brnna05/senior-design-strength-training/README.md

# senior-design-strength-training
Senior Design project for ECE 364D - Fitness wearable for strength training
