brnna05/senior-design-strength-training/machine-learning/plots/figure_20260218_140859.png

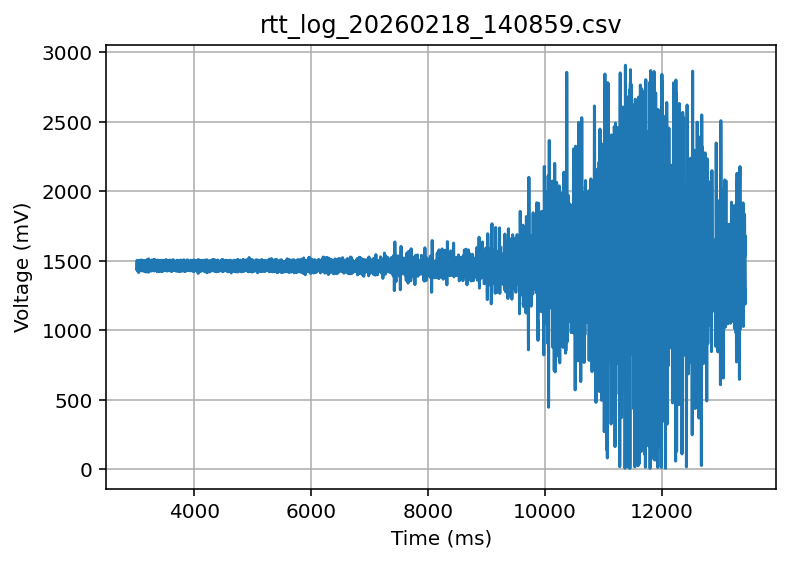
machine-learning/plots/figure_20260218_140859.png
