brnna05/senior-design-strength-training/machine-learning/plots/figure_20260218_141500.png

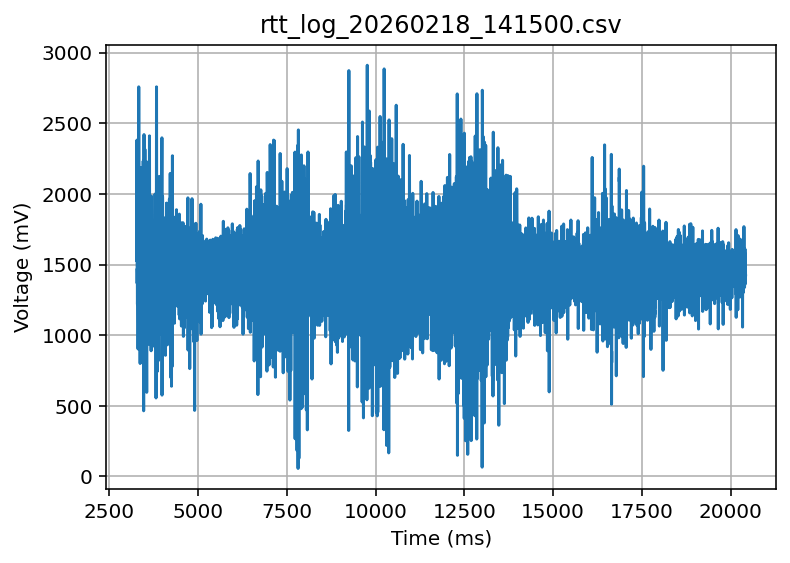
machine-learning/plots/figure_20260218_141500.png
