brnna05/senior-design-strength-training/machine-learning/plots/figure_20260218_141545.png

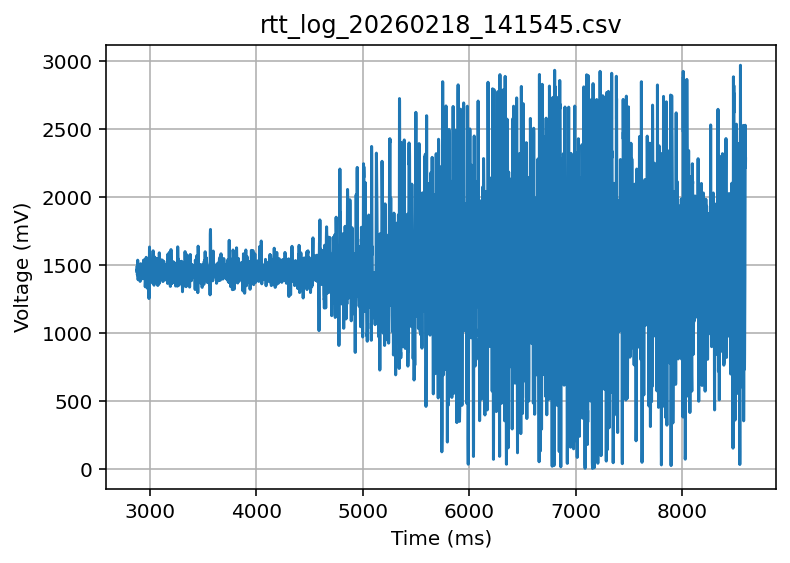
machine-learning/plots/figure_20260218_141545.png
