brnna05/senior-design-strength-training/machine-learning/plots/figure_20260218_142350.png

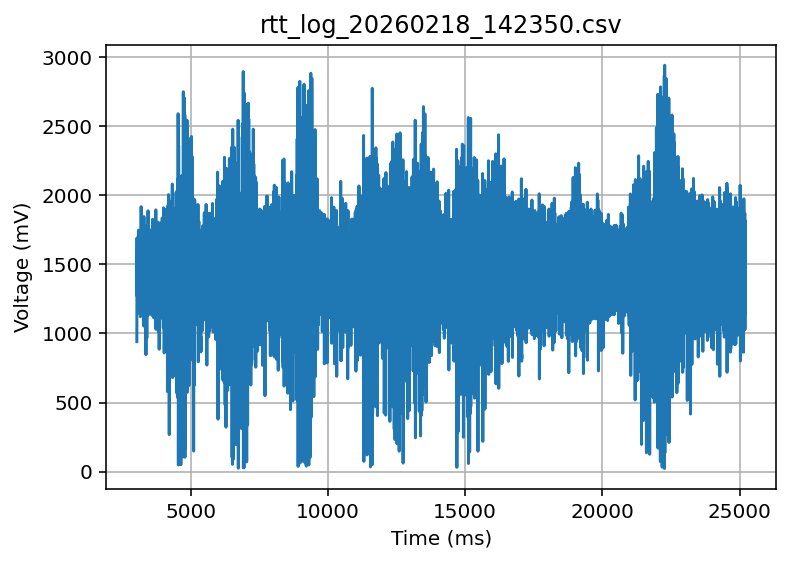
machine-learning/plots/figure_20260218_142350.png
