brnna05/senior-design-strength-training/machine-learning/plots/figure_20260218_142451.png

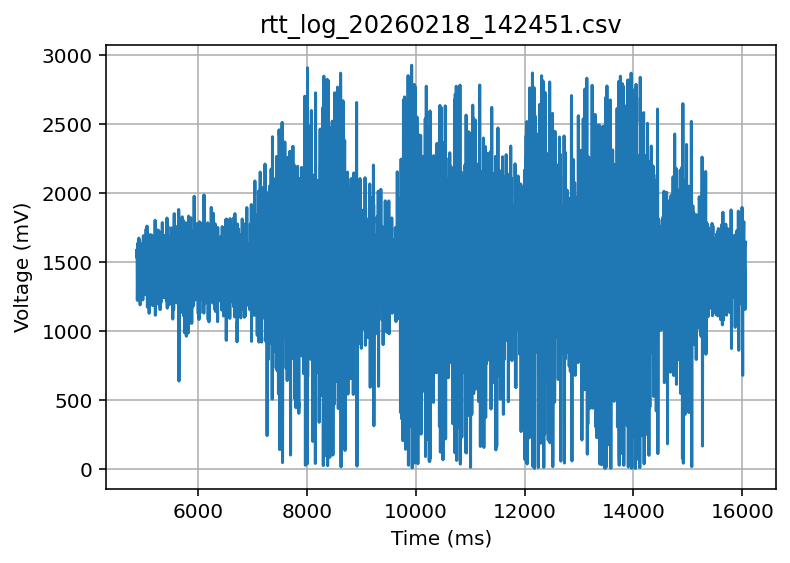
machine-learning/plots/figure_20260218_142451.png
