brnna05/senior-design-strength-training/machine-learning/plots/figure_20260304_135931.png

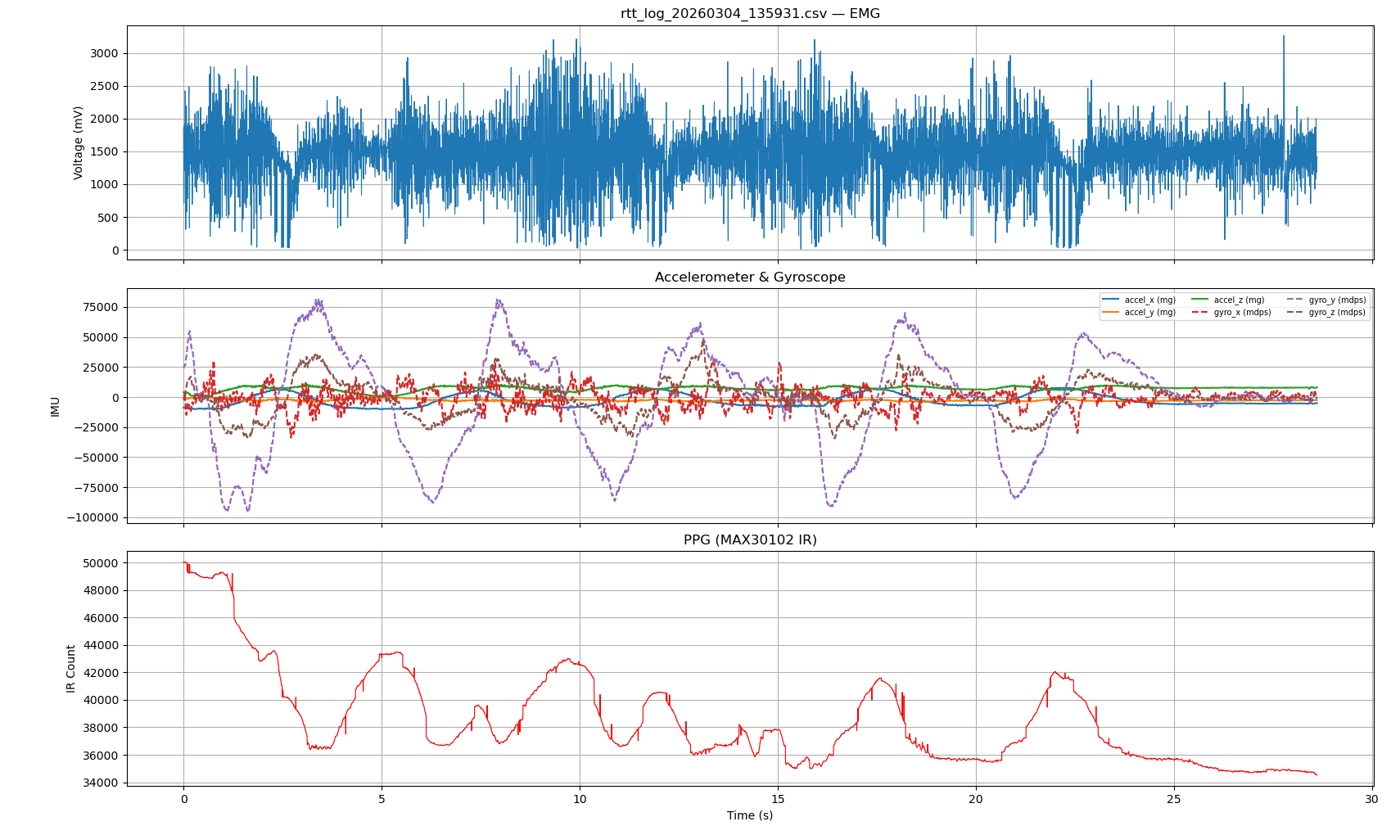
machine-learning/plots/figure_20260304_135931.png
