brnna05/senior-design-strength-training/machine-learning/plots/figure_20260311_135713.png

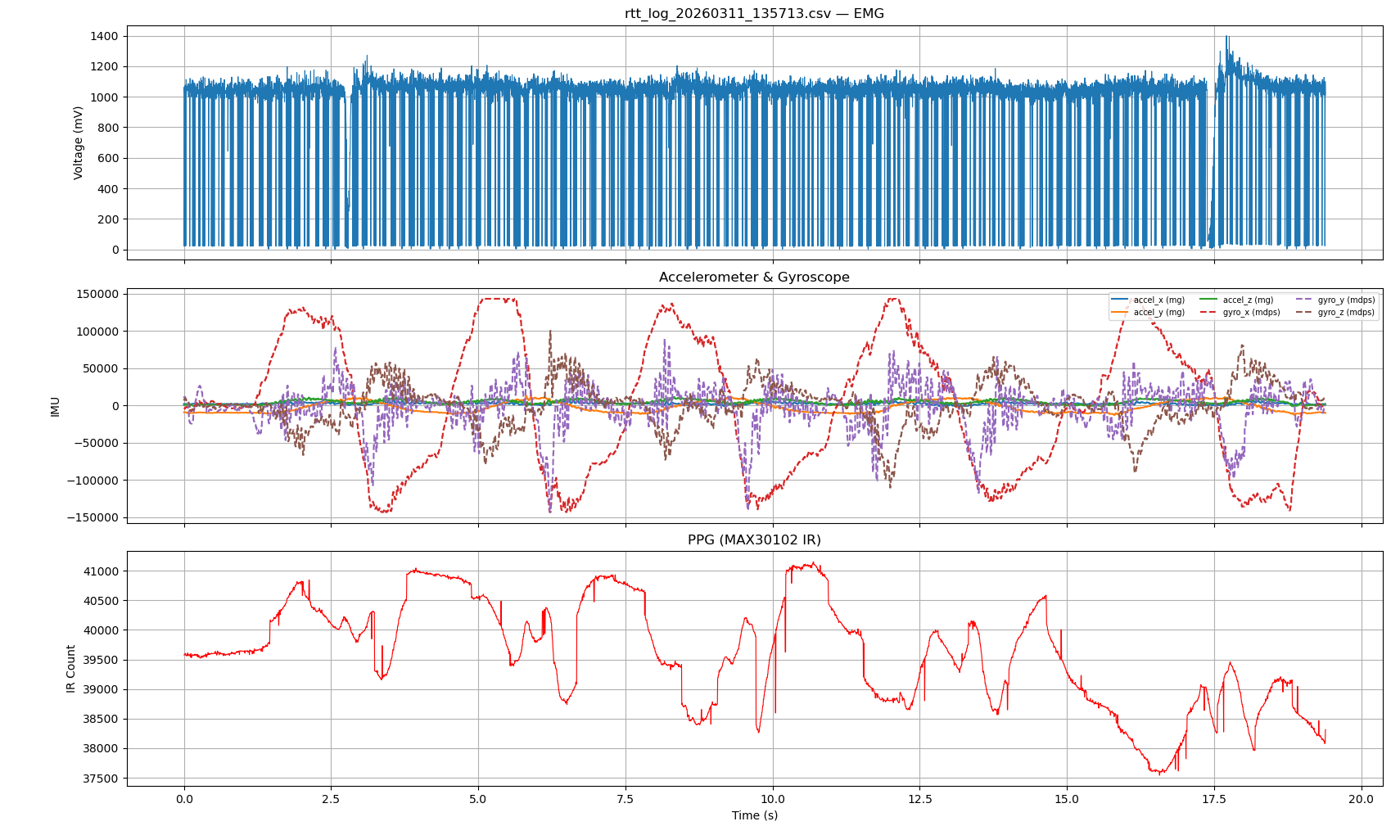
machine-learning/plots/figure_20260311_135713.png
