brnna05/senior-design-strength-training/machine-learning/plots/figure_20260311_140114.png

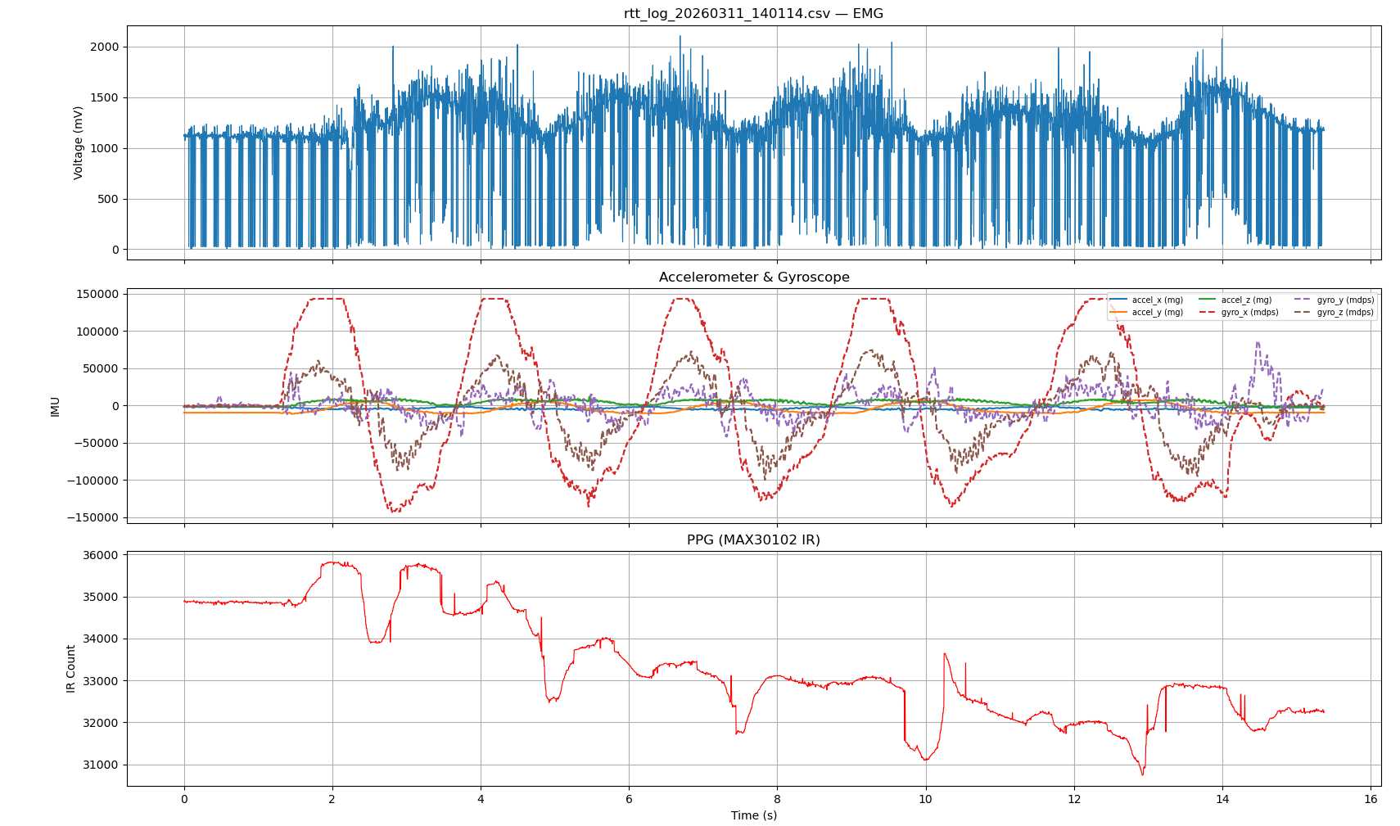
machine-learning/plots/figure_20260311_140114.png
