brnna05/senior-design-strength-training/machine-learning/plots/figure_20260311_145541.png

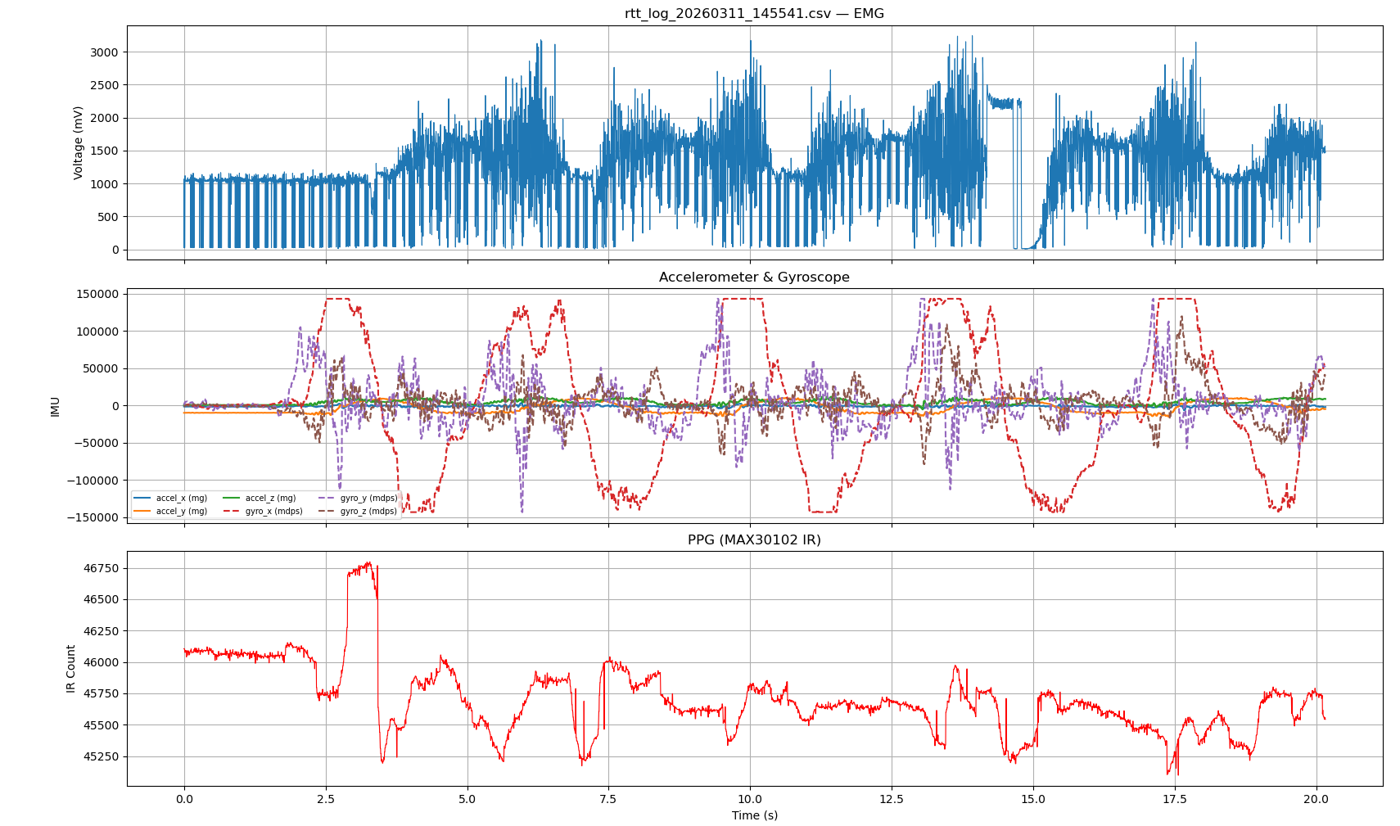
machine-learning/plots/figure_20260311_145541.png
