brnna05/senior-design-strength-training/machine-learning/plots/figure_20260311_151058.png

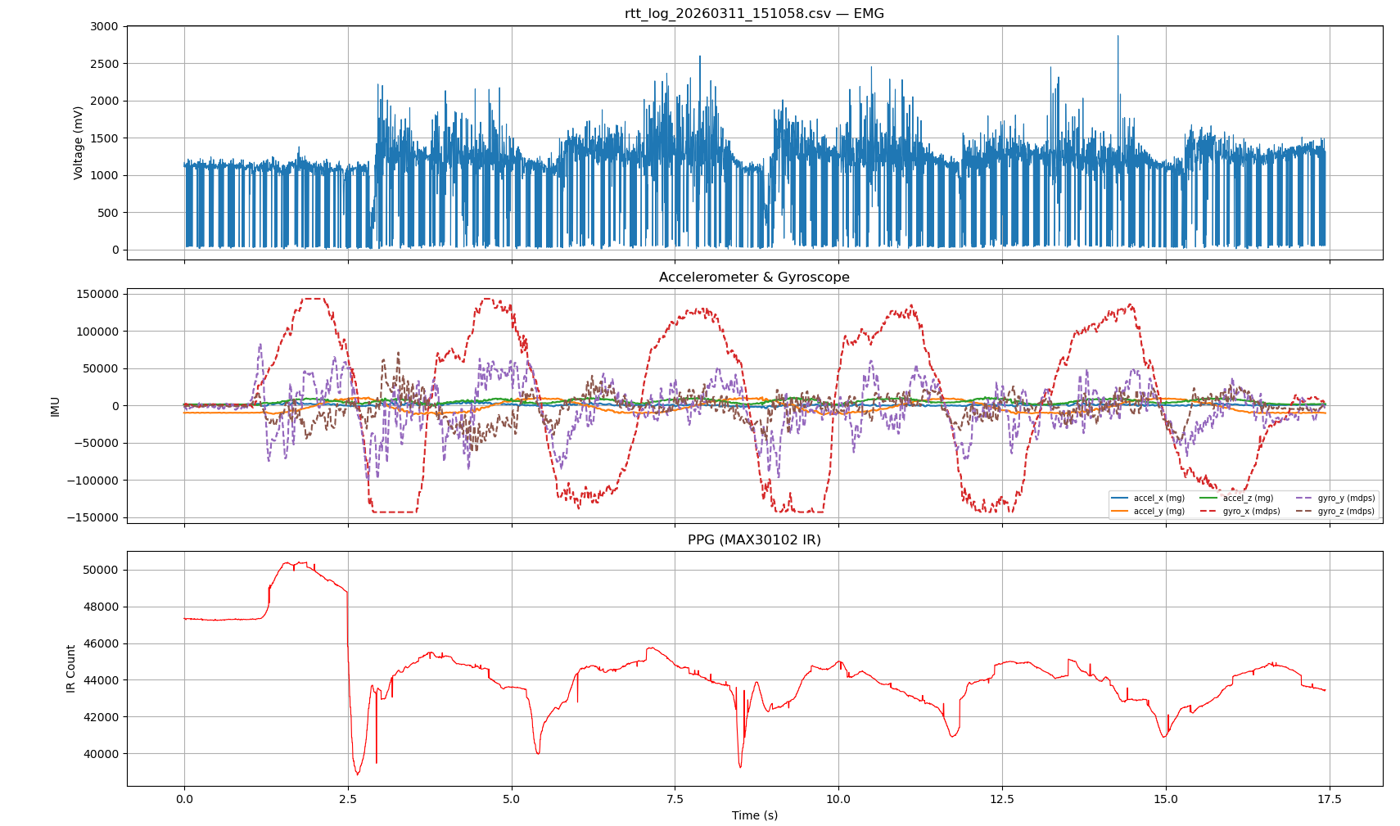
machine-learning/plots/figure_20260311_151058.png
