brnna05/senior-design-strength-training/app-software/wireframes/HistoryPage.pdf

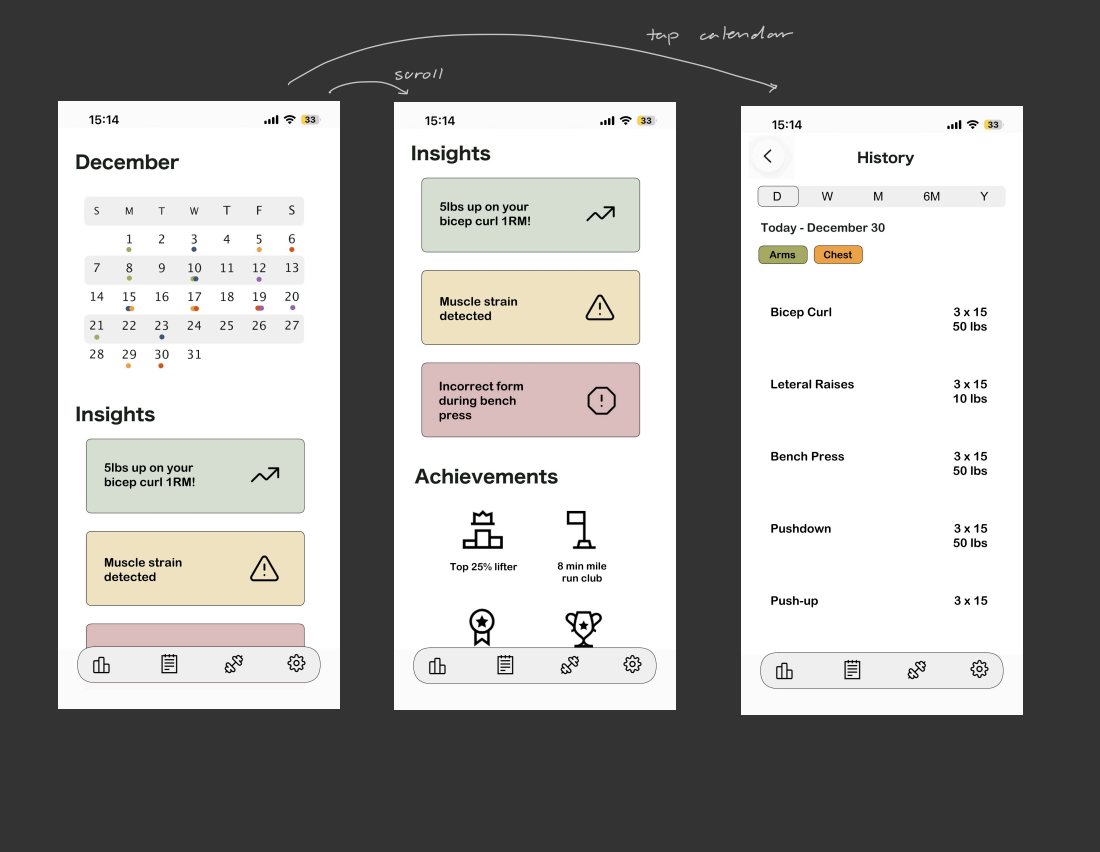
[picture p49: page 1]
