brnna05/senior-design-strength-training/app-software/wireframes/app-wireframes.pdf

# full-body

< | history

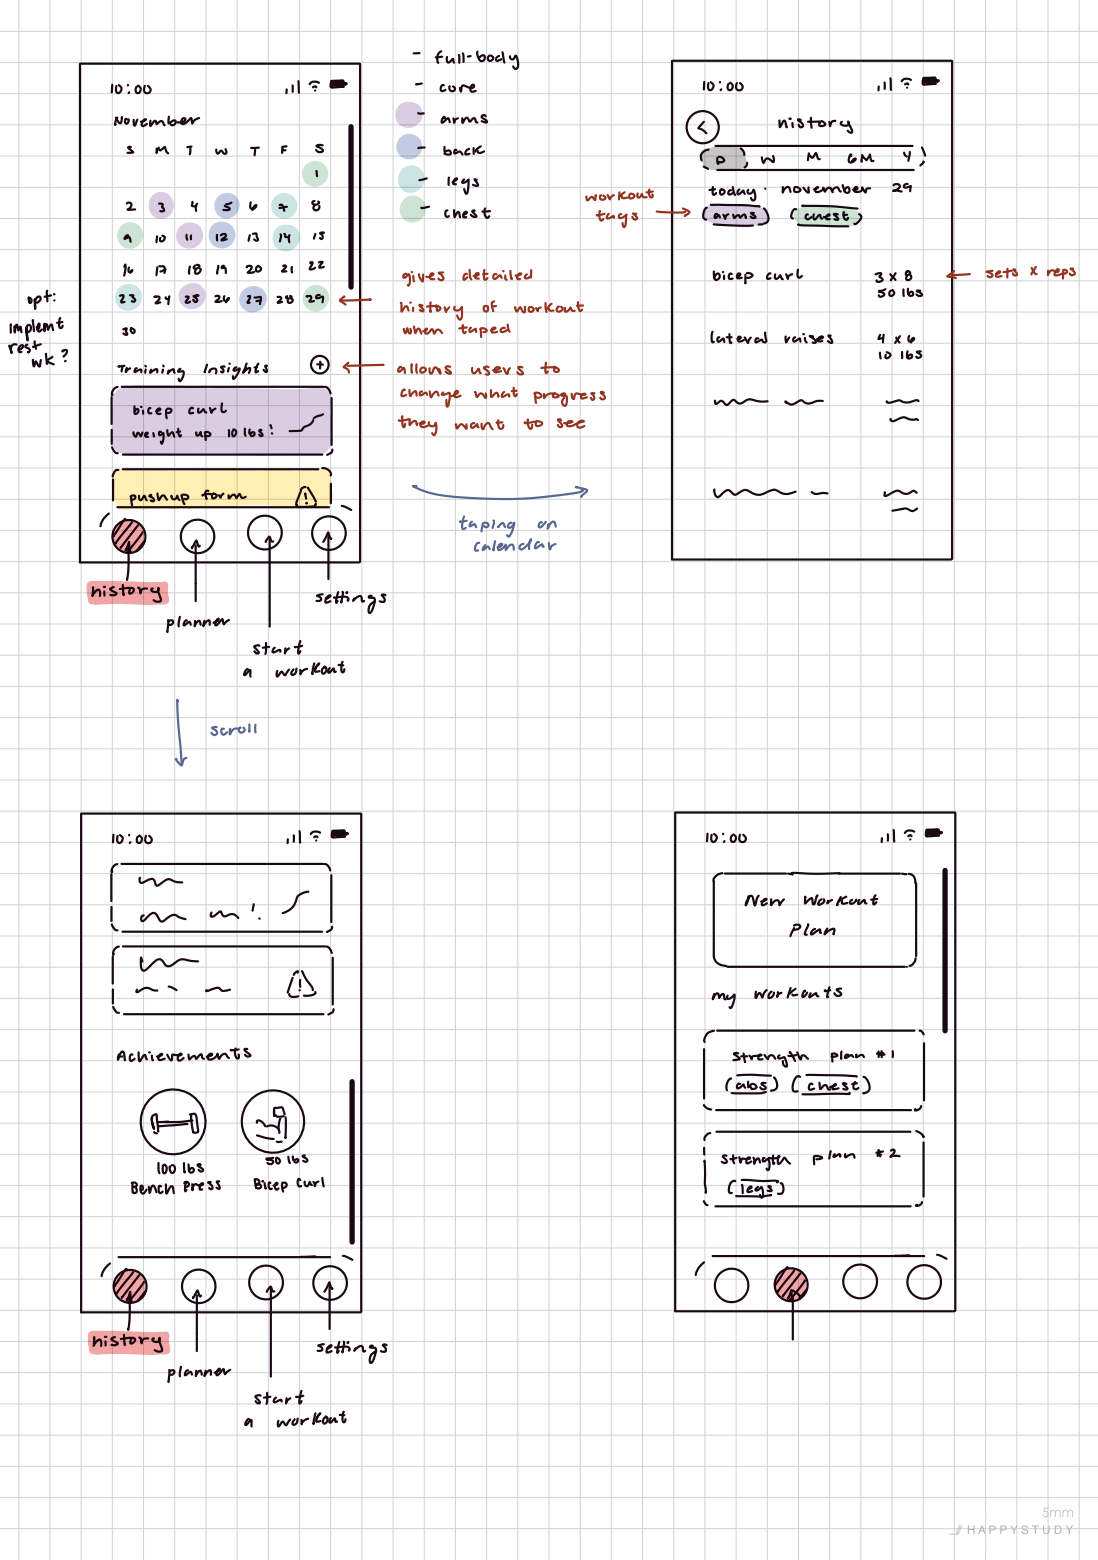
[picture p50: page 1]
cure; November; arms; Sin; back; legs; workout; today november; Chest; tuys; karms); Quest; gives; detailed; bicep; curl; Sets; reps; opt:; history of; implemt; when; taped; lateral; raises; restk ?; Training Insights; allows; users; change what; progress; weight up; they; want; see; pushup form; taping; calendar; New; Workout; Plan; work outS my L; Achievements; strength; plan #1; Es) (chest); plan; Bench; Press; Bicep curl; ↓ cen; history; settings; planner; Start

history | | planner | ↓ | Scroll | Start a | workout | settings

Q Strength | plan | #1
bicep curl | E.

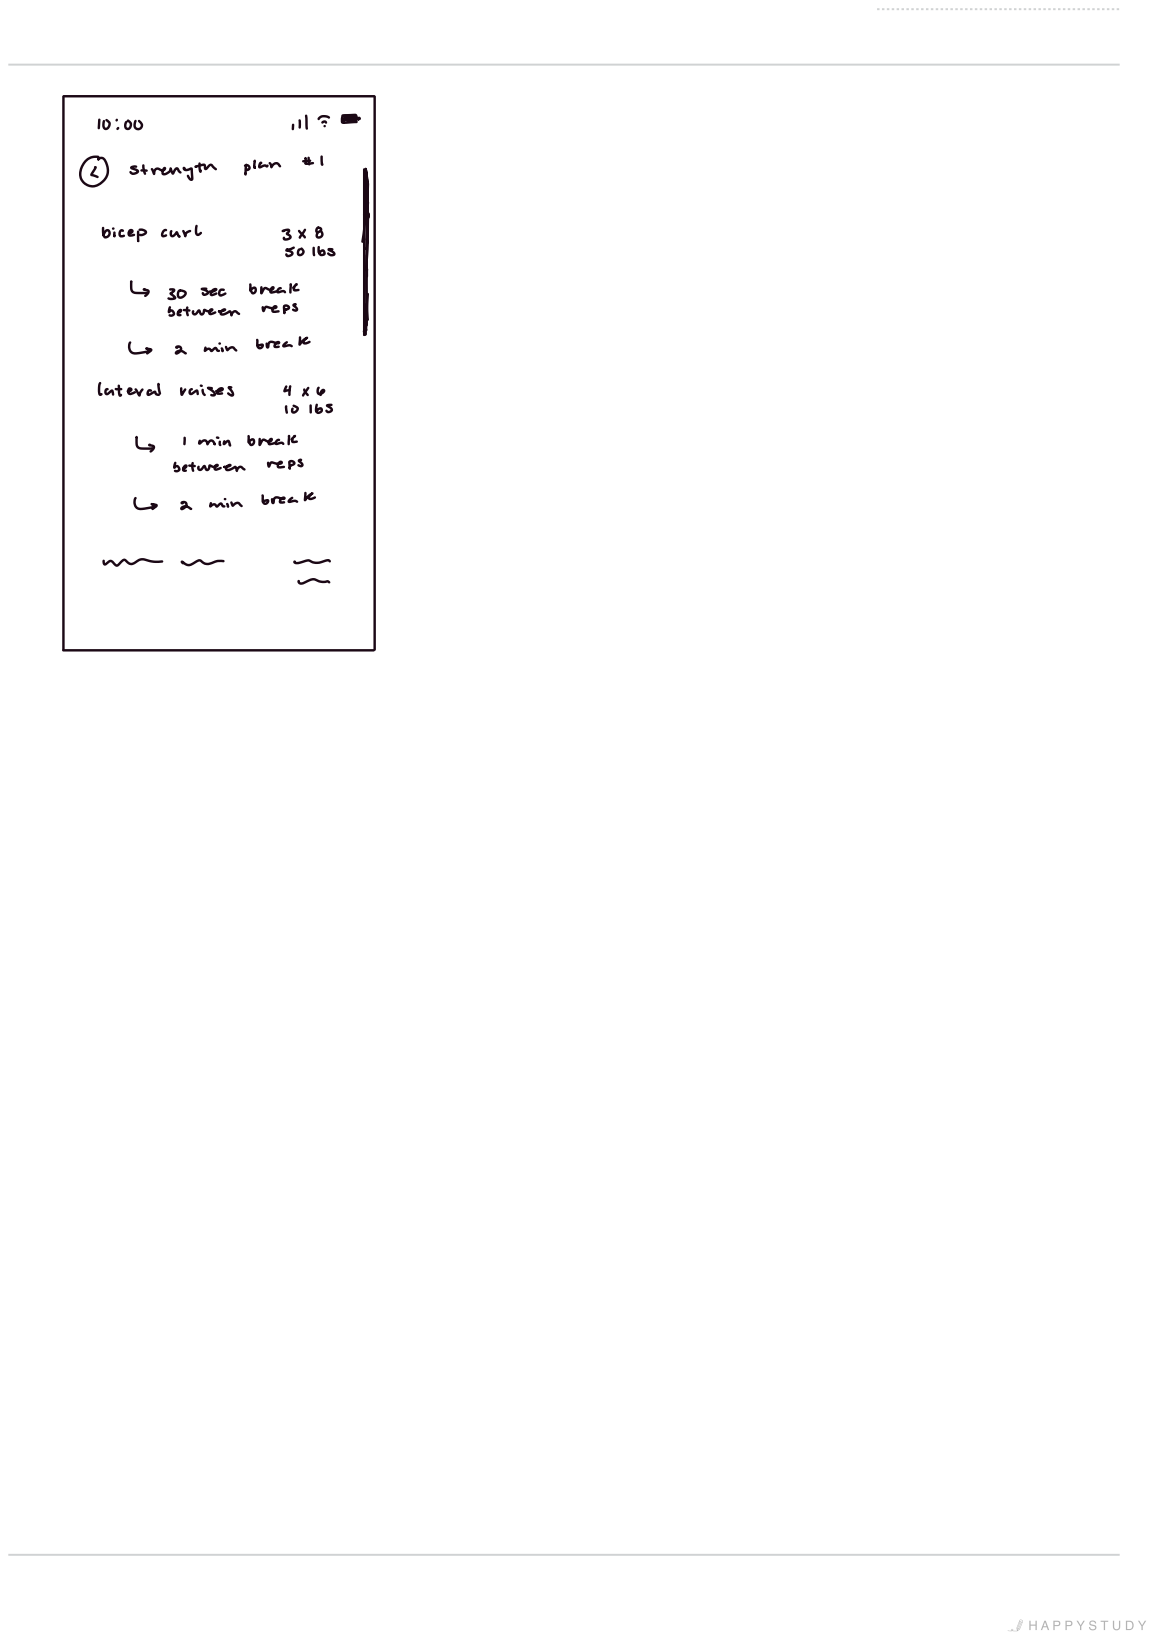
[picture p51: page 2]
between; see; break; reps; min; lateral; raises

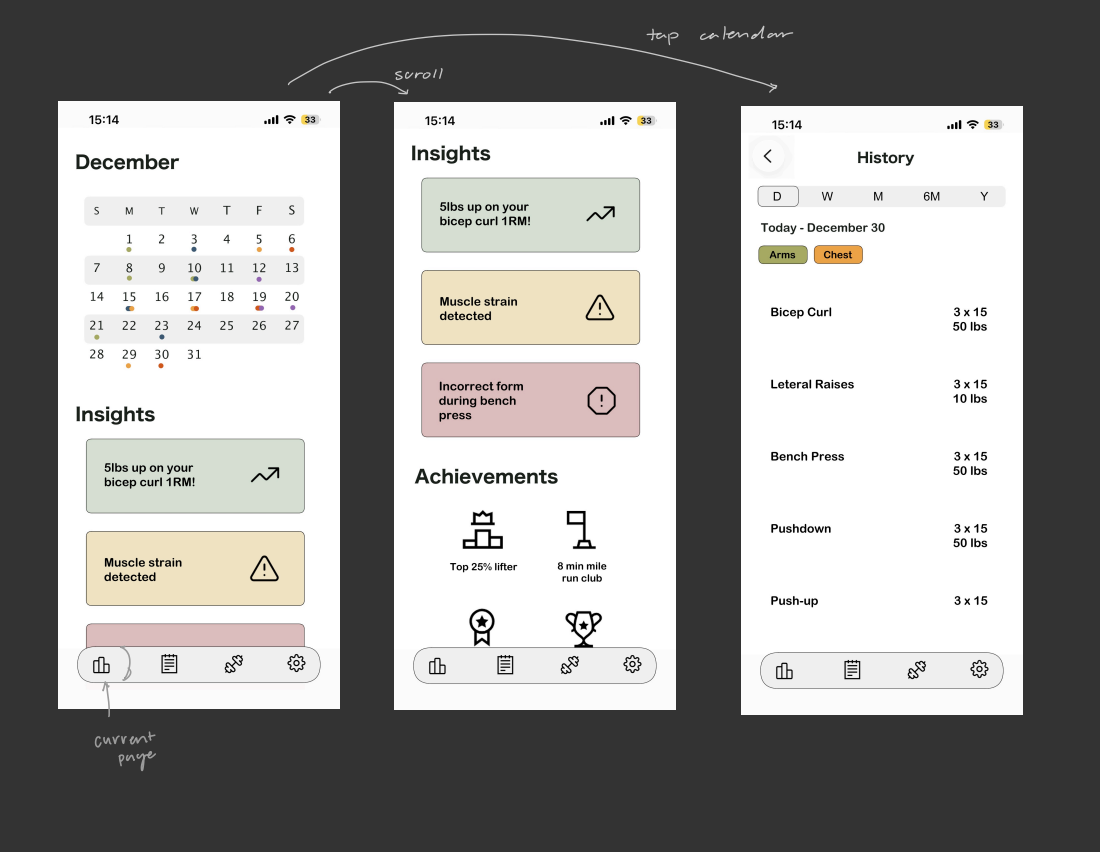
[picture p52: page 3]

Workout | Planner
#hada | new | runo | -

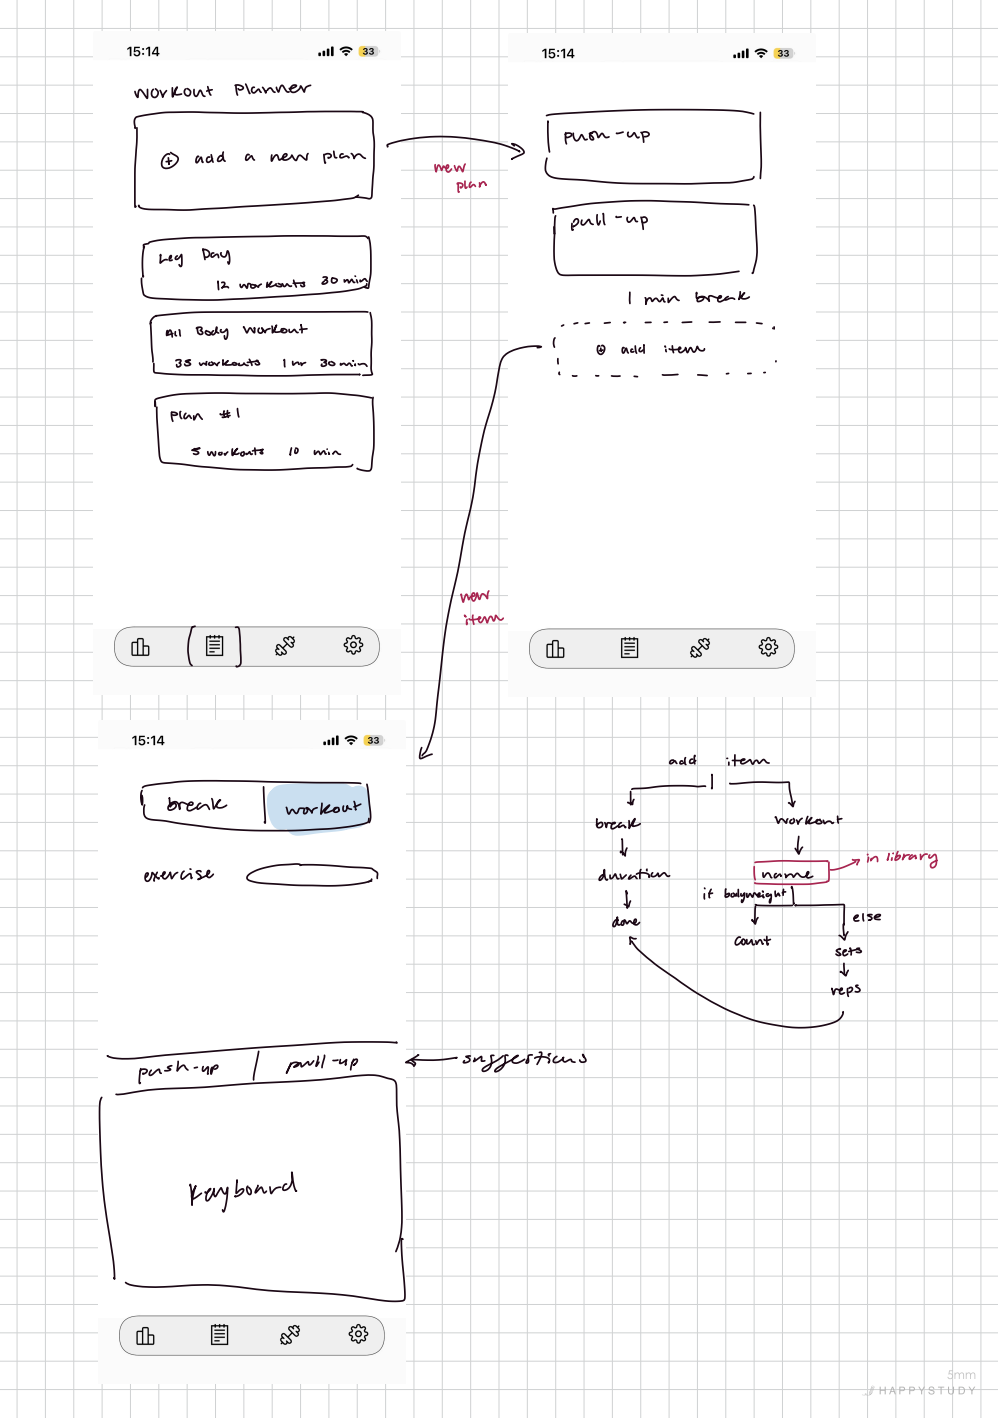
[picture p53: page 4]
Truan-up; plan; iteyeay; Trun-up workouts; 30 min; min; break; All; Body; Workout; aitem; add; item; ear/; workout; i11 break; Time-; in library; evercise; duration; bodyweight/; done; Telse; ↓ count; sets; -reps; -trush-no /; pull-upsuggestions; licting

select | a | workout

# plan

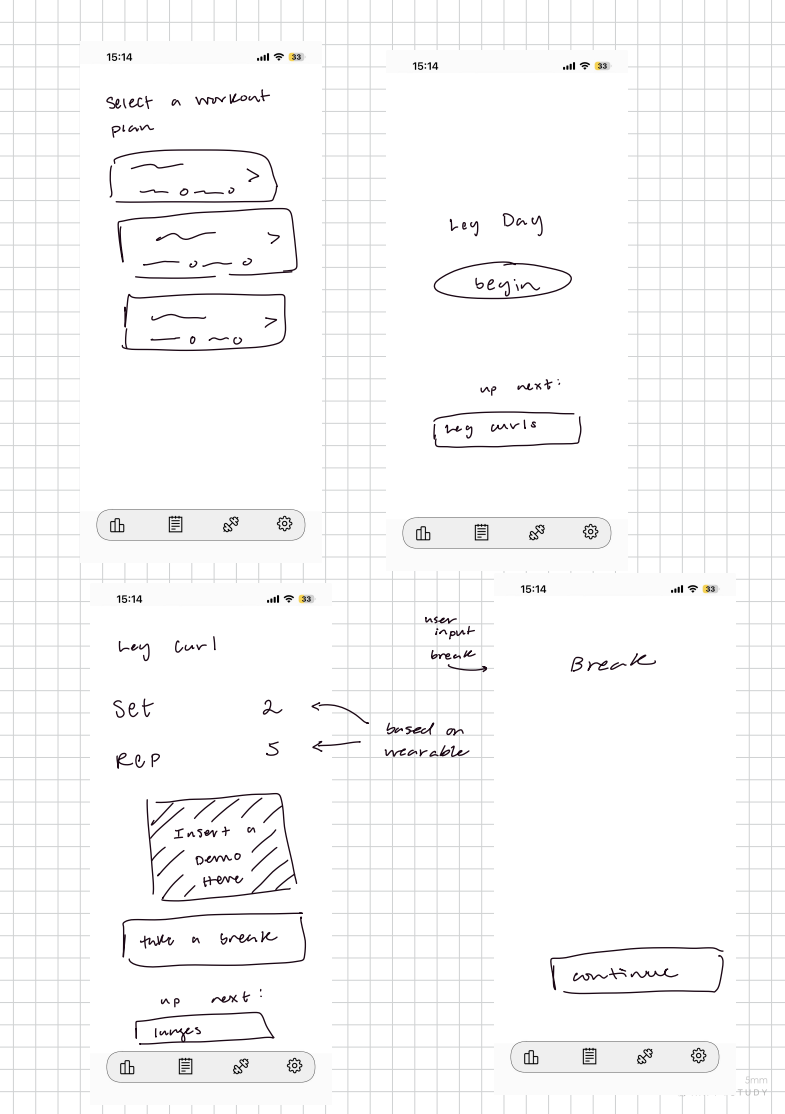
[picture p54: page 5]
For>; Ley; Day 7; Seyin; next :; Eycris; user input; hey; curl; break; - Break; set; based; wearable; RCP #; next; Fina; larges

# settings

# #count1

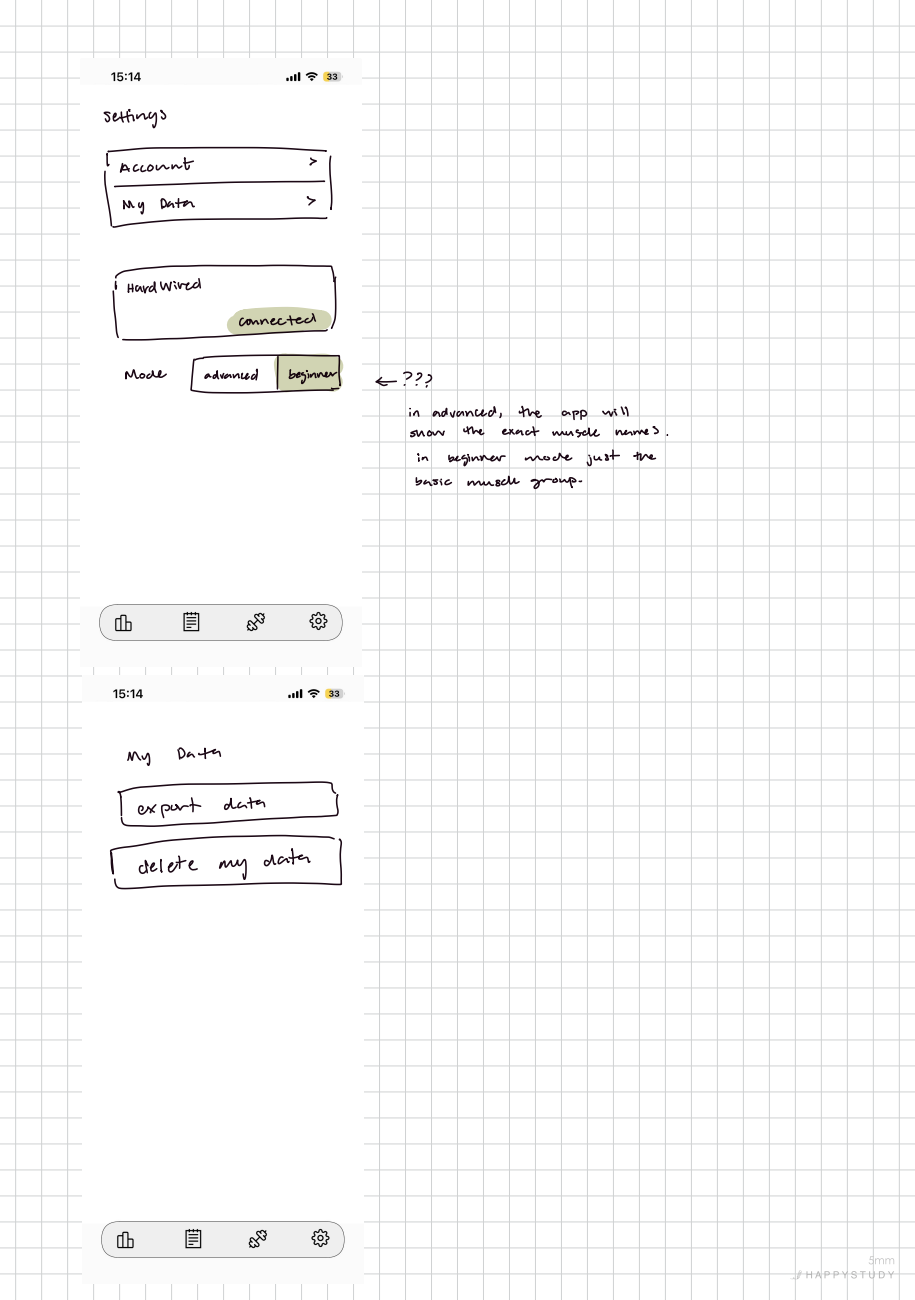
[picture p55: page 6]
Data; Hardwired; necical; moderanced/beginner; advanced ,; the; app; will; snow; exact; muscle; names .; beginner; mode; just the; basic; musch group-; Data t date etemy data
