brnna05/senior-design-strength-training/hardware/wearable/wearable.kicad_pcb

## KiCad design hardware/wearable/wearable.kicad_pcb (2026-03-15)

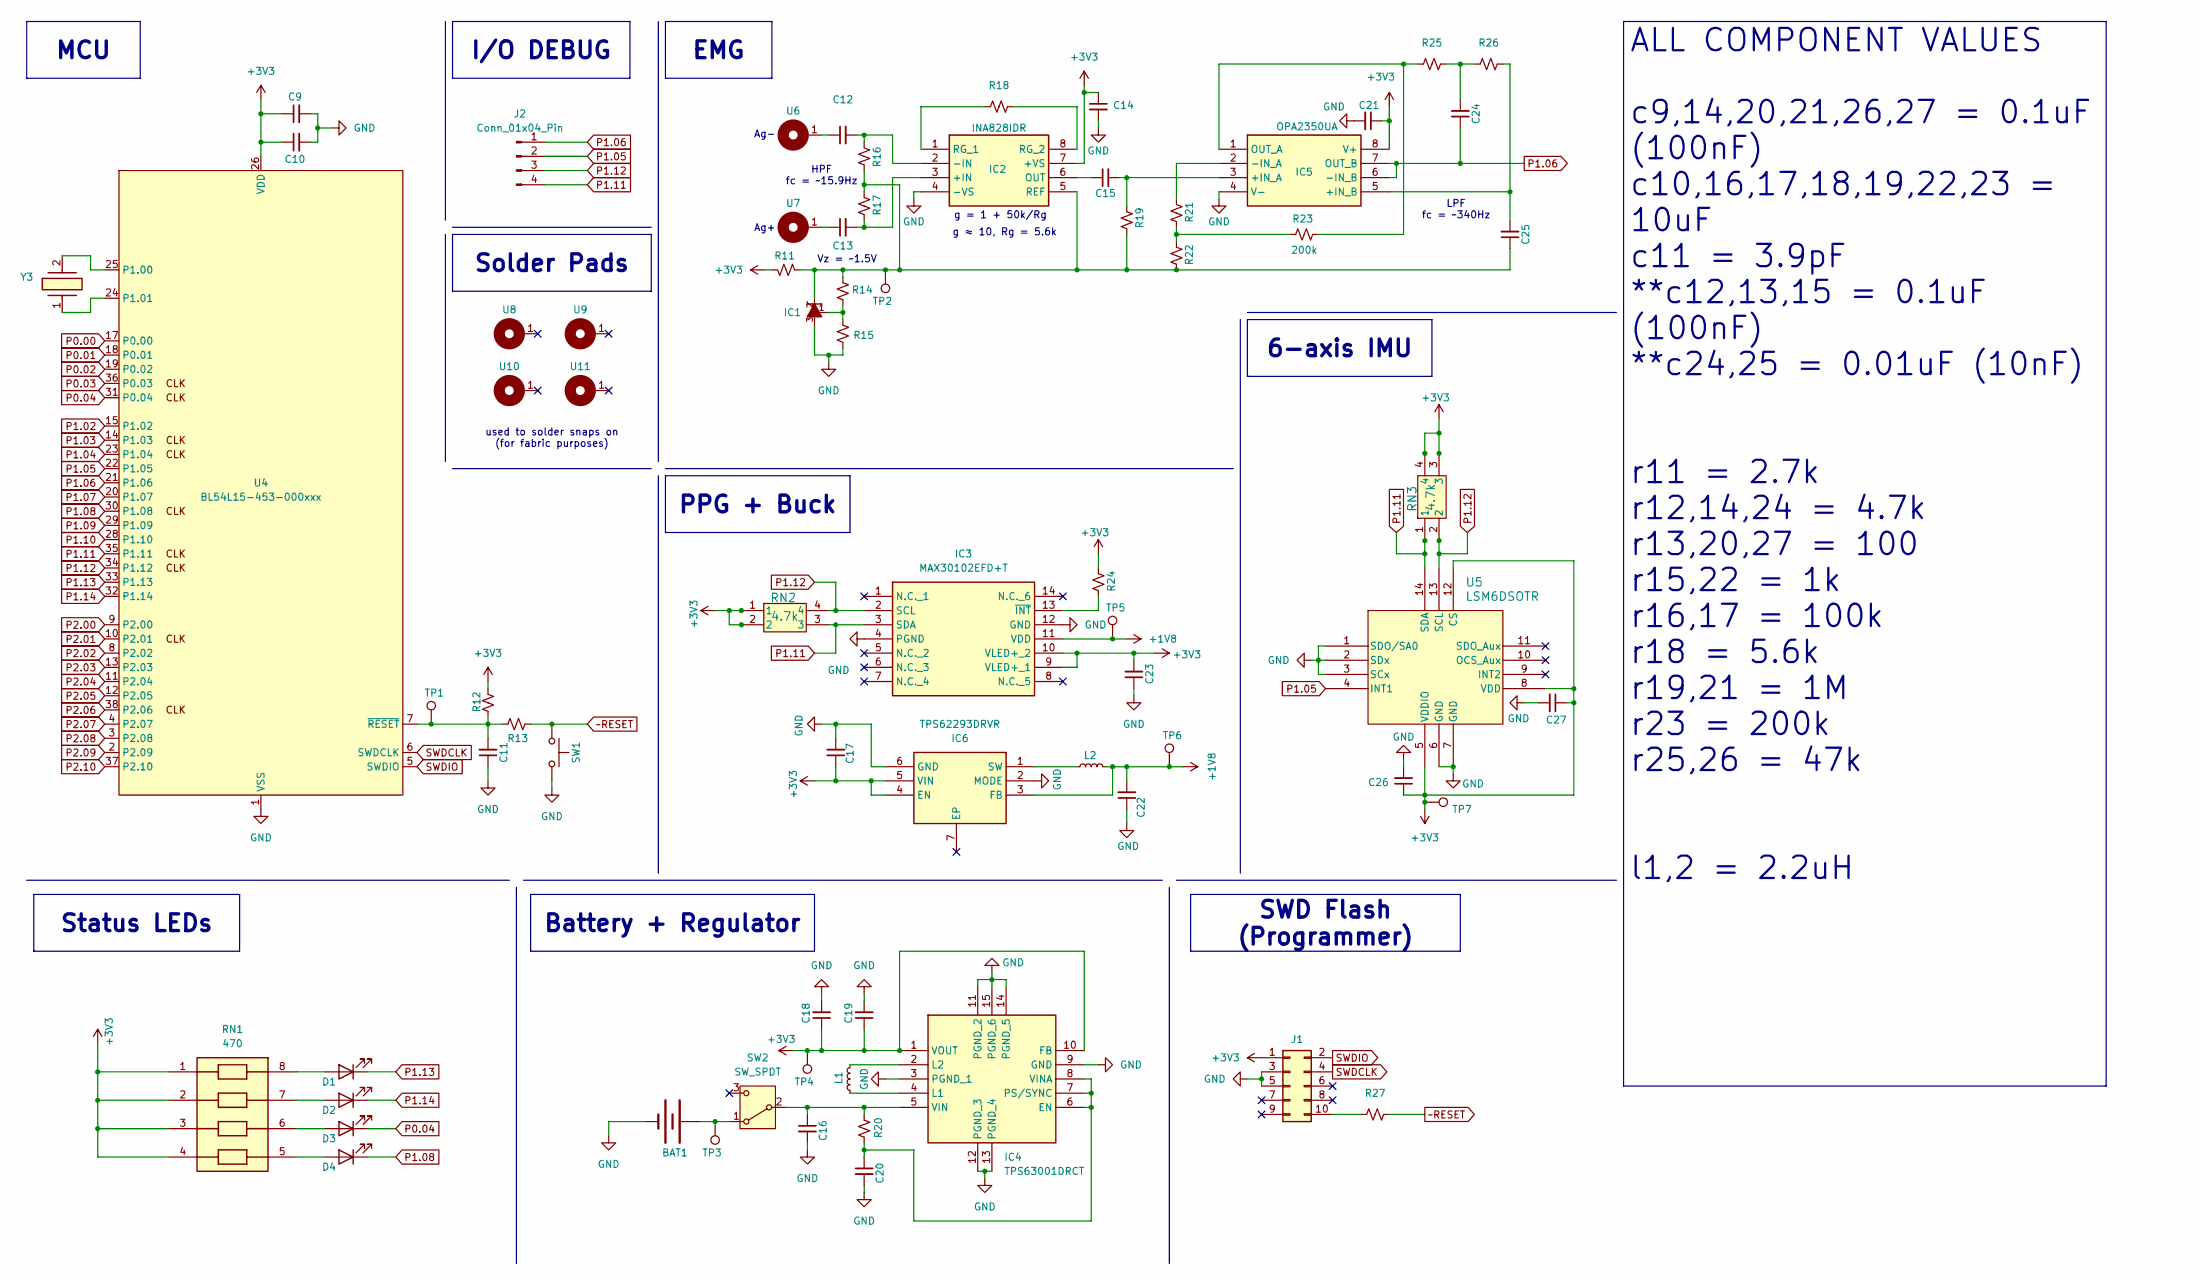
[picture p56: schematic pcb.kicad_sch]

Parts:
BAT1: 20mm coincell; batteryHolder
C9: 100nF; ceramicCap0_1uF
C10, C16, C17, C18, C19, C22, C23: 10uF; ceramicCap10uF
C11: 3.9pF; ceramicCap3_9pF
C12, C13, C15: 0.1uF; C0GCap0_1uF
C14, C20, C21, C26, C27: 0.1uF; ceramicCap0_1uF
C24, C25: 0.01uF; C0GCap0_01uF
D1, D2, D3, D4: LED; greenLed
IC1: LM4041CILPR; lm4041; Mouser Part Number 595-LM4041CILPR
IC2: INA828IDR; ina828; Mouser Part Number 595-INA828IDR
IC3: MAX30102EFD+T; ppg; Mouser Part Number 700-MAX30102EFD+T
IC4: TPS63001DRCT; boost3_3v; Mouser Part Number 595-TPS63001DRCT
IC5: OPA2350UA; opAmp; Mouser Part Number 595-OPA2350UA
IC6: TPS62293DRVR; buck1_8v; Mouser Part Number 595-TPS62293DRVR
J1: Conn_02x05_Odd_Even; swdConnector
J2: Conn_01x04_Pin; pinHeader1x4
L1, L2: 2.2uH; inductor
R11: 2.7k; res2K7
R12, R14, R24: 4.7k; res4K7
R13, R20, R27: 100; res100
R15, R22: 1k; res1K
R16, R17: 100k; res100K
R18: 5.6k; res5K6
R19, R21: 1M; res1M
R23: 200k; res200K
R25, R26: 47k; red47K
RN1: 470; resArray4; Mouser Part Number 603-YC164-JR-07470RL
RN2, RN3: 4.7k; resArray2
SW1: SW_Push; button
SW2: SW_SPDT; spdt
TP1, TP2, TP3, TP4, TP5, TP6, TP7: TestPoint; testPoint
U4: BL54L15-453-000xxx; BL54Lxx-LGA-39_14x10mm
U5: LSM6DSOTR; imu
U6, U7: silverContacts
U8, U9, U10, U11: solderPad
Y3: NX3215SA-32.768K-STD-MUA-8; crystal32768; Mouser Part Number 344-NX3215SA32768K8

Connections:
+1V8: C22.2, IC3.11 (VDD), IC6.3 (FB), L2.1, TP5.1, TP6.1
+3V3: C9.1, C10.1, C14.1, C17.1, C18.1, C19.1, C21.1, C23.2, C26.1, C27.1, IC2.7 (+VS), IC3.9 (VLED+_1), IC3.10 (VLED+_2), IC4.1 (VOUT), IC4.10 (FB), IC5.8 (V+), IC6.4 (EN), IC6.5 (VIN), J1.1, R11.1, R12.1, R24.1, RN1.1, RN1.2, RN1.3, RN1.4, RN2.1, RN2.2, RN3.3, RN3.4, TP4.1, TP7.1, U4.26 (VDD), U5.5 (VDDIO), U5.8 (VDD), U5.12 (CS)
GND: BAT1.NEGATIVE (-), C9.2, C10.2, C11.1, C14.2, C16.2, C17.2, C18.2, C19.2, C20.2, C21.2, C22.1, C23.1, C26.2, C27.2, IC1.3, IC2.4 (-VS), IC3.4 (PGND), IC3.12 (GND), IC4.3 (PGND_1), IC4.9 (GND), IC4.11 (PGND_2), IC4.12 (PGND_3), IC4.13 (PGND_4), IC4.14 (PGND_5), IC4.15 (PGND_6), IC5.4 (V-), IC6.2 (MODE), IC6.6 (GND), J1.3, J1.5, R15.2, SW1.2, U4.1 (VSS), U4.16 (VSS), U4.27 (VSS), U4.39 (VSS), U5.1 (SDO/SA0), U5.2 (SDx), U5.3 (SCx), U5.6 (GND), U5.7 (GND)
unnamed: C12.1, U6.1
unnamed: C13.1, U7.1
unnamed: C24.2, R25.2, R26.1
unnamed: D1.2 (A), RN1.8
unnamed: D2.2 (A), RN1.7
unnamed: D3.2 (A), RN1.6
unnamed: D4.2 (A), RN1.5
unnamed: IC1.1, R14.2, R15.1
unnamed: C13.2, IC2.3 (+IN), R17.2
unnamed: C12.2, IC2.2 (-IN), R16.1
unnamed: C15.1, IC2.6 (OUT)
unnamed: C25.1, IC1.2, IC2.5 (REF), R11.2, R14.1, R16.2, R17.1, R19.2, R22.2, TP2.1
unnamed: IC2.1 (RG_1), R18.1
unnamed: IC2.8 (RG_2), R18.2
unnamed: IC3.13 (~INT), R24.2
unnamed: C20.1, IC4.6 (EN), IC4.7 (PS/SYNC), IC4.8 (VINA), R20.2
unnamed: IC4.4 (L1), L1.1
unnamed: IC4.2 (L2), L1.2
unnamed: C16.1, IC4.5 (VIN), R20.1, SW2.2 (B)
unnamed: C15.2, IC5.3 (+IN_A), R19.1
unnamed: C25.2, IC5.5 (+IN_B), R26.2
unnamed: IC5.2 (-IN_A), R21.1
unnamed: IC5.1 (OUT_A), R23.2, R25.1
unnamed: IC6.1 (SW), L2.2
unnamed: J1.10, R27.1
unnamed: R21.2, R22.1, R23.1
unnamed: BAT1.POSITIVE@1 (+), BAT1.POSITIVE@2 (+), BAT1.POSITIVE@3 (+), BAT1.POSITIVE@4 (+), SW2.1 (A), TP3.1
unnamed: U4.25 (P1.00), Y3.2 (CRYSTAL_2)
unnamed: U4.24 (P1.01), Y3.1
unnamed: C11.2, R12.2, R13.1, TP1.1, U4.7 (~RESET)
P0.00: U4.17 (P0.00)
P0.01: U4.18 (P0.01)
P0.02: U4.19 (P0.02)
P0.03: U4.36 (P0.03)
P0.04: D3.1 (K), U4.31 (P0.04)
P1.02: U4.15 (P1.02)
P1.03: U4.14 (P1.03)
P1.04: U4.23 (P1.04)
P1.05: J2.2, U4.22 (P1.05), U5.4 (INT1)
P1.06: C24.1, IC5.6 (-IN_B), IC5.7 (OUT_B), J2.1, U4.21 (P1.06)
P1.07: U4.20 (P1.07)
P1.08: D4.1 (K), U4.30 (P1.08)
P1.09: U4.29 (P1.09)
P1.10: U4.28 (P1.10)
P1.11: IC3.3 (SDA), J2.4, RN2.3, RN3.1, U4.35 (P1.11), U5.14 (SDA)
P1.12: IC3.2 (SCL), J2.3, RN2.4, RN3.2, U4.34 (P1.12), U5.13 (SCL)
P1.13: D1.1 (K), U4.33 (P1.13)
P1.14: D2.1 (K), U4.32 (P1.14)
P2.00: U4.9 (P2.00)
P2.01: U4.10 (P2.01)
P2.02: U4.8 (P2.02)
P2.03: U4.13 (P2.03)
P2.04: U4.11 (P2.04)
P2.05: U4.12 (P2.05)
P2.06: U4.38 (P2.06)
P2.07: U4.4 (P2.07)
P2.08: U4.3 (P2.08)
P2.09: U4.2 (P2.09)
P2.10: U4.37 (P2.10)
SWDCLK: J1.4, U4.6 (SWDCLK)
SWDIO: J1.2, U4.5 (SWDIO)
~RESET: R13.2, R27.2, SW1.1

Notes on the sheet:
HPF fc = ~15.9Hz
g ≈ 10, Rg = 5.6k
Vz = ~1.5V
Ag+
Ag-
used to solder snaps on (for fabric purposes)
g = 1 + 50k/Rg
LPF fc = ~340Hz
I/O DEBUG
MCU
6-axis IMU
EMG
SWD Flash (Programmer)
ALL COMPONENT VALUES c9,14,20,21,26,27 = 0.1uF (100nF) c10,16,17,18,19,22,23 = 10uF c11 = 3.9pF **c12,13,15 = 0.1uF (100nF) **c24,25 = 0.01uF (10nF) r11 = 2.7k r12,14,24 = 4.7k r13,20,27 = 100 r15,22 = 1k r16,17 = 100k r18 = 5.6k r19,21 = 1M r23 = 200k r25,26 = 47k l1,2 = 2.2uH
Solder Pads
Battery + Regulator
Status LEDs
PPG + Buck

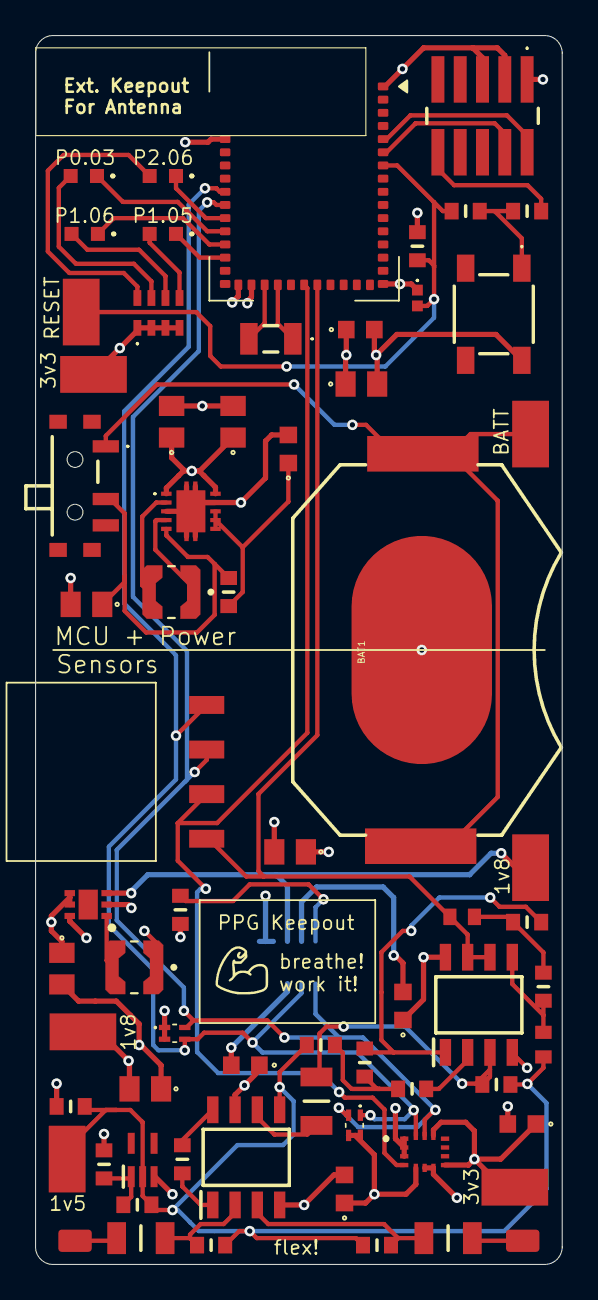
[picture p57: board wearable.kicad_pcb from above]

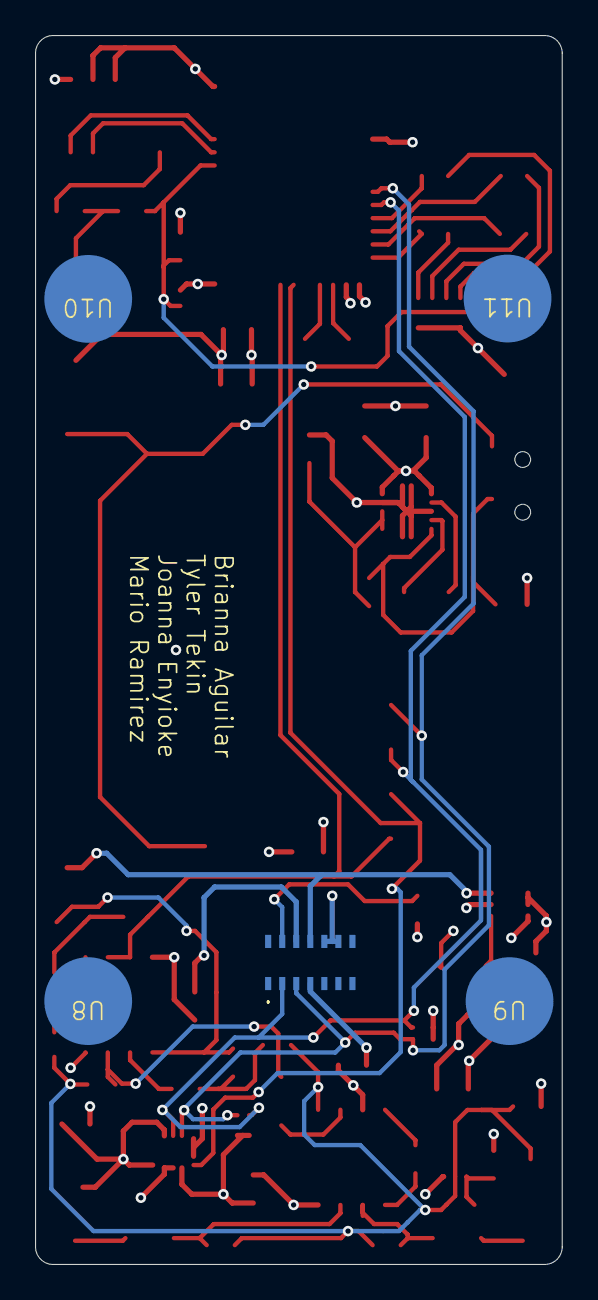
[picture p58: board wearable.kicad_pcb from below]

Board: 4 copper layers, 30.0 x 70.0 mm, 72 parts (5 on the bottom side), 44 nets.
