brnna05/senior-design-strength-training/firmware/src/main.cpp

#include <zephyr/kernel.h>
#include <zephyr/bluetooth/bluetooth.h>
#include <zephyr/bluetooth/hci.h>
#include <zephyr/bluetooth/conn.h>
#include <zephyr/bluetooth/gatt.h>
#include <zephyr/drivers/gpio.h>
#include "PPG.hpp"
#include "IMU.h"
#include "ADC.h"
#include "classifier.h"

/* ── Message types — keep in sync with RN app ── */
#define MSG_REP     0x01   /* [0x01, rep_count_uint8]   — new rep detected  */
#define MSG_BPM     0x02   /* [0x02, bpm_uint8]         — heart rate update  */
#define MSG_FATIGUE 0x03   /* [0x03, fatigue_level 0-3] — fatigue update     */

/*
 * Classifier tick rate (ms).
 * 100 ms gives 10 Hz resolution for rep detection.
 * Matches CLASSIFIER_PERIOD_MS defined in classifier.c.
 */
#define CLASSIFIER_PERIOD_MS  100

/*
 * How often to push a BPM + fatigue notification over BLE (ms).
 * 1 s is the finest useful resolution given the PPG algorithm.
 */
#define BPM_NOTIFY_PERIOD_MS 5000

static const struct bt_le_adv_param *adv_param = BT_LE_ADV_PARAM(
    BT_LE_ADV_OPT_CONNECTABLE,
    BT_GAP_ADV_FAST_INT_MIN_2,
    BT_GAP_ADV_FAST_INT_MAX_2,
    NULL);

static const struct bt_data ad[] = {
    BT_DATA_BYTES(BT_DATA_FLAGS, (BT_LE_AD_GENERAL | BT_LE_AD_NO_BREDR)),
    BT_DATA(BT_DATA_NAME_COMPLETE,
            CONFIG_BT_DEVICE_NAME,
            sizeof(CONFIG_BT_DEVICE_NAME) - 1),
};

static const struct bt_data sd[] = {
    BT_DATA_BYTES(BT_DATA_UUID128_ALL,
        BT_UUID_128_ENCODE(0x12340001, 0x0000, 0x0000, 0x0000, 0x000000000001)),
};

/* ── UUIDs — keep in sync with RN app ── */
static const struct bt_uuid_128 rep_svc_uuid = BT_UUID_INIT_128(
    BT_UUID_128_ENCODE(0x12340001, 0x0000, 0x0000, 0x0000, 0x000000000001));

static const struct bt_uuid_128 rep_char_uuid = BT_UUID_INIT_128(
    BT_UUID_128_ENCODE(0x12340001, 0x0000, 0x0000, 0x0000, 0x000000000002));

/* ── GATT service ── */
BT_GATT_SERVICE_DEFINE(rep_svc,
    BT_GATT_PRIMARY_SERVICE(&rep_svc_uuid),
    BT_GATT_CHARACTERISTIC(&rep_char_uuid.uuid,
        BT_GATT_CHRC_NOTIFY,
        BT_GATT_PERM_NONE,
        NULL, NULL, NULL),
    BT_GATT_CCC(NULL, BT_GATT_PERM_READ | BT_GATT_PERM_WRITE),
);

/* ── Generic 2-byte notify helper [msgType, value] ── */
static void notify(uint8_t msg_type, uint8_t value)
{
    uint8_t buf[2] = { msg_type, value };
    bt_gatt_notify(NULL, &rep_svc.attrs[2], buf, sizeof(buf));
    printk("BLE notify: type=0x%02x value=%d\n", msg_type, value);
}

/* ── Connection callbacks ── */
static void on_connected(struct bt_conn *conn, uint8_t err)
{
    if (err) {
        printk("Connection failed (err %u)\n", err);
        return;
    }
    printk("Connected — sending initial state\n");
    notify(MSG_BPM,     0);
    notify(MSG_REP,     0);
    notify(MSG_FATIGUE, (uint8_t)FATIGUE_NONE);
}

static void on_disconnected(struct bt_conn *conn, uint8_t reason)
{
    printk("Disconnected (reason %u) — restarting advertising\n", reason);
    bt_le_adv_start(adv_param, ad, ARRAY_SIZE(ad), NULL, 0);
}

static struct bt_conn_cb conn_callbacks = {
    .connected    = on_connected,
    .disconnected = on_disconnected,
};

/* ══════════════════════════════════════════════════════════════════════════
 * Classifier work + timer (100 ms)
 *
 * This is the core sensing loop:
 *   1. classifier_update() fetches EMG metrics and runs the rep FSM.
 *   2. If a new rep was detected, immediately notify the RN app.
 * ══════════════════════════════════════════════════════════════════════════ */
static struct k_work classifier_work;
static struct k_timer classifier_timer;

static void classifier_work_handler(struct k_work *work)
{
    classifier_result_t *r = classifier_update();

    if (r->new_rep) {
        /*
         * Clamp to uint8_t (rep_count is uint16_t; 255 reps/set is
         * well beyond any realistic maximum, but guard anyway).
         */
        uint8_t rep_byte = (r->rep_count > 255) ? 255
                                                 : (uint8_t)r->rep_count;
        notify(MSG_REP, rep_byte);

        /*
         * Also push fatigue immediately after each rep so the app
         * can update its UI without waiting for the 1 s BPM tick.
         */
        notify(MSG_FATIGUE, (uint8_t)r->fatigue_level);

        printk("MAIN: Rep %d — fatigue=%d\n",
               (int)r->rep_count, (int)r->fatigue_level);
    }
}

static void classifier_timer_handler(struct k_timer *t)
{
    k_work_submit(&classifier_work);
}

/* ══════════════════════════════════════════════════════════════════════════
 * BPM + fatigue periodic notification (1 s)
 *
 * Sends BPM and current fatigue level at a low rate for display updates
 * even between reps.
 * ══════════════════════════════════════════════════════════════════════════ */
static struct k_work bpm_work;
static struct k_timer bpm_timer;

static void bpm_work_handler(struct k_work *work)
{
    int32_t bpm = ppg_get_bpm();

    if (bpm >= 0) {
        notify(MSG_BPM, (uint8_t)bpm);
    }

    /* Always send the current fatigue level every second so the UI stays
     * in sync even if no new reps have occurred.                         */
    notify(MSG_FATIGUE, (uint8_t)classifier_get_fatigue_level());
}

static void bpm_timer_handler(struct k_timer *t)
{
    k_work_submit(&bpm_work);
}

/* ══════════════════════════════════════════════════════════════════════════
 * LED GPIO specs
 * ══════════════════════════════════════════════════════════════════════════ */
static const struct gpio_dt_spec ble_led =
    GPIO_DT_SPEC_GET(DT_PATH(zephyr_user), ble_led_gpios);
static const struct gpio_dt_spec imu_led =
    GPIO_DT_SPEC_GET(DT_PATH(zephyr_user), imu_led_gpios);
static const struct gpio_dt_spec ppg_led =
    GPIO_DT_SPEC_GET(DT_PATH(zephyr_user), ppg_led_gpios);
static const struct gpio_dt_spec emg_led =
    GPIO_DT_SPEC_GET(DT_PATH(zephyr_user), emg_led_gpios);

/* ══════════════════════════════════════════════════════════════════════════
 * main()
 * ══════════════════════════════════════════════════════════════════════════ */
int main(void)
{
    /* ── GPIO setup ── */
    if (!gpio_is_ready_dt(&ble_led) ||
        !gpio_is_ready_dt(&imu_led) ||
        !gpio_is_ready_dt(&ppg_led) ||
        !gpio_is_ready_dt(&emg_led)) {
        return -1;
    }

    gpio_pin_configure_dt(&ble_led, GPIO_OUTPUT_INACTIVE);
    gpio_pin_configure_dt(&imu_led, GPIO_OUTPUT_INACTIVE);
    gpio_pin_configure_dt(&ppg_led, GPIO_OUTPUT_INACTIVE);
    gpio_pin_configure_dt(&emg_led, GPIO_OUTPUT_INACTIVE);

    /* ── Bluetooth ── */
    bt_conn_cb_register(&conn_callbacks);

    if (bt_enable(NULL)) {
        printk("BT enable failed\n");
        return -1;
    }

    if (bt_le_adv_start(adv_param, ad, ARRAY_SIZE(ad), sd, ARRAY_SIZE(sd))) {
        printk("BT advertising failed\n");
        return -1;
    }

    gpio_pin_set_dt(&ble_led, 1);
    printk("BLE advertising as \"%s\"\n", CONFIG_BT_DEVICE_NAME);

    /* ── BPM notify timer (1 s) ── */
    k_work_init(&bpm_work, bpm_work_handler);
    k_timer_init(&bpm_timer, bpm_timer_handler, NULL);
    k_timer_start(&bpm_timer,
                  K_MSEC(BPM_NOTIFY_PERIOD_MS),
                  K_MSEC(BPM_NOTIFY_PERIOD_MS));

    /* ── PPG — 200 Hz internal timer ── */
    if (ppg_init(HR_SAMPLE_RATE)) {
        printk("PPG init failed\n");
        return -1;
    }
    gpio_pin_set_dt(&ppg_led, 1);

    /* ── ADC/EMG — 4 kHz internal timer ── */
    if (ADC_init()) {
        printk("ADC init failed\n");
        return -1;
    }
    gpio_pin_set_dt(&emg_led, 1);

    /*
     * IMU is omitted: hardware not functional on current PCB revision.
     * The imu_led is lit to indicate the hardware is recognized by
     * Zephyr even if not actively sampled.
     */
    static const struct device *imu_dev = DEVICE_DT_GET(IMU_NODE);
    if (!device_is_ready(imu_dev)) {
        printk("IMU: device %s not ready — skipping (PCB issue known)\n",
               imu_dev->name);
        /* Non-fatal: classifier runs on EMG + PPG only. */
    } else {
        gpio_pin_set_dt(&imu_led, 1);
    }

    /* ── Classifier — 100 ms tick ── */
    classifier_init();
    k_work_init(&classifier_work, classifier_work_handler);
    k_timer_init(&classifier_timer, classifier_timer_handler, NULL);
    k_timer_start(&classifier_timer,
                  K_MSEC(CLASSIFIER_PERIOD_MS),
                  K_MSEC(CLASSIFIER_PERIOD_MS));

    printk("MAIN: All subsystems up. Classifier running at %d ms tick.\n",
           CLASSIFIER_PERIOD_MS);

    while (1) {
        k_sleep(K_FOREVER);
    }

    return 0;
}
