brnna05/senior-design-strength-training/firmware/src/ADC.h

#ifndef _ADC_H_
#define _ADC_H_

#include <zephyr/drivers/adc.h>
#include <zephyr/kernel.h>
#include <stdint.h>
#include <stdbool.h>

#ifdef __cplusplus
extern "C" {
#endif

/* ── Sampling config ─────────────────────────────────────────────────────── */
#define SEQUENCE_SAMPLES      128    /* power-of-2 window for EMG analysis     */
#define SEQUENCE_RESOLUTION   12

/* ── ADC device-tree ─────────────────────────────────────────────────────── */
#define ADC_NODE        DT_ALIAS(adc0)
#define CHANNEL_VREF(node_id) DT_PROP_OR(node_id, zephyr_vref_mv, 0)
#define CHANNEL_COUNT 1

/* ── EMG activation thresholds ───────────────────────────────────────────── */
/* Tune these to your electrode placement / gain stage */
#define EMG_ACTIVATION_THRESHOLD_MV   90    // initial cold-start threshold
#define EMG_ACTIVATION_MULTIPLIER     2     // threshold = baseline * this
#define EMG_BASELINE_MIN_MV           15    // floor — never go below this
#define EMG_BASELINE_MAX_MV           300   // ceiling — ignore outliers
#define EMG_FATIGUE_ZCR_LOW           50

/* ── EMG result struct ───────────────────────────────────────────────────── */
/**
 * @brief Holds all per-window EMG metrics derived from a differential
 *        bipolar electrode pair placed over the biceps brachii.
 *
 * Interpretation guide
 * --------------------
 * peak_to_peak_mv  – gross signal amplitude; correlates with motor-unit
 *                    recruitment (more fibres firing → larger swing).
 * rms_mv           – true power estimate; standard "activation level" metric.
 *                    Use for force/contraction-intensity estimation.
 * mav_mv           – mean absolute value; computationally cheap alternative
 *                    to RMS, very common in prosthetics & HCI.
 * zcr              – zero-crossing rate; rough spectral index.
 *                    Fresh muscle → higher ZCR (~50-150 Hz median freq).
 *                    Fatiguing muscle → ZCR drops as MPF shifts downward.
 * is_active        – simple threshold gate: TRUE when RMS > threshold.
 * fatigue_flag     – heuristic: active but ZCR below expected range.
 * dc_offset_mv     – any residual DC; should be ~0 with good differential
 *                    electrodes; large offset hints at poor contact / motion.
 */
typedef struct {
    int32_t  peak_to_peak_mv;   /* max - min of window [mV]                  */
    int32_t  rms_mv;            /* sqrt( mean(x²) ) [mV]                     */
    int32_t  mav_mv;            /* mean( |x| ) [mV]                          */
    uint16_t zcr;               /* zero-crossing count in window             */
    int32_t  dc_offset_mv;      /* mean value (bias) [mV]                    */
    bool     is_active;         /* RMS > EMG_ACTIVATION_THRESHOLD_MV         */
    bool     fatigue_flag;      /* active + low ZCR heuristic                */
} emg_metrics_t;

#define EMG_WINDOW_SIZE (1<<10) // 1k
#define EMG_ANALYSIS_SAMPLES  256 

extern emg_metrics_t emg_data;
extern int32_t emg_window[];

/* ── Public API ──────────────────────────────────────────────────────────── */

/* Initializes ADC for channels in overlay */
int ADC_init(void);

/* Reads the data from the channel and displays it */
void EMG_read();

int32_t *EMG_get_raw();

int EMG_compute_from_window();

emg_metrics_t *EMG_get_metrics();

int32_t EMG_get_adaptive_threshold(void);

#ifdef __cplusplus
}
#endif

#endif /* _ADC_H_ */
