brnna05/senior-design-strength-training/(commit log)

2025-11-03 emg module-- subject to change
    [LM4041 Voltage Reference Design.xlsx, kicad-for-wearable.kicad_sch, wearable.kicad_pcb, wearable.kicad_sch]
2026-02-02 updated kicad again..
    [pcb.kicad_sch, sketch.kicad_sch, wearable.kicad_sch]
2026-02-14 adc module for csv data collection
2026-02-15 update adc to be a timer ISR
2026-02-16 hardware so far
    [LM4041 Voltage Reference Design.xlsx, pcb.kicad_sch, sketch.kicad_sch]
2026-02-16 data logging instructions
    [rtt_log_20260216_133355.csv]
2026-02-16 schematic and bom are complete
    [pcb.kicad_sch, wearable.kicad_sch]
2026-02-18 working on 3x8cm pcb
    [LM4041 Voltage Reference Design.xlsx, pcb.kicad_sch, wearable.kicad_pcb]
2026-02-18 team data
    [rtt_log_20260218_132615.csv, rtt_log_20260218_133000.csv, rtt_log_20260218_133137.csv, rtt_log_20260218_133349.csv, rtt_log_20260218_133702.csv, rtt_log_20260218_134209.csv, rtt_log_20260218_135612.csv, rtt_log_20260218_140317.csv]
2026-03-02 i2c ports to be 1.11/12 and ppg can communicate via ir readings. working to implement ble and working imu in tandem with ppg
2026-03-04 add imu/ppg
2026-03-04 imu set up w/ adc
2026-03-04 REVERT TO THIS IS HARDWARE GOES TO SHIT
    [bom.csv, designators.csv, positions.csv]
2026-03-04 data with imu/ppg
    [rtt_log_20260304_135931.csv, rtt_log_20260304_140158.csv, rtt_log_20260304_140502.csv, rtt_log_20260304_140911.csv, rtt_log_20260304_141335.csv, rtt_log_20260304_141456.csv, rtt_log_20260304_141544.csv, rtt_log_20260304_141632.csv]
2026-03-10 ahhhhhhhhhhhhhhhhhhhhhhh firmware is no longer a submodule per peer request... thanks brianna...
    [pcb.kicad_sch, wearable.kicad_pcb]
2026-03-11 data from 03/11
    [rtt_log_20260216_133355.csv, rtt_log_20260304_140158.csv, rtt_log_20260304_140502.csv, rtt_log_20260304_140911.csv, rtt_log_20260304_141335.csv, rtt_log_20260304_141456.csv, rtt_log_20260304_141544.csv, rtt_log_20260304_141632.csv]
2026-03-15 main does the printing
2026-03-15 clean hw folder
    [LM4041 Voltage Reference Design.xlsx]
2026-04-22 ml stuff
    [rtt_log_20260218_132615.csv, rtt_log_20260218_133000.csv, rtt_log_20260218_133137.csv, rtt_log_20260218_133349.csv, rtt_log_20260218_133702.csv, rtt_log_20260218_134209.csv, rtt_log_20260218_135612.csv, rtt_log_20260218_140317.csv]
2026-04-26 ble+ppg on pcb work, imu doesn't
    [ADC.c, ADC.h, IMU.c, IMU.h, LSM6DS3TR.c, LSM6DS3TR.h, PPG.cpp, PPG.hpp]
2026-04-26 fix imu on pcb, need to fix adc
    [main.cpp]
2026-04-26 i lied adc works but imu doesn't
    [IMU.c, main.cpp]
